Jerome-kai/sickcamera/software/assets/boot-screen.png

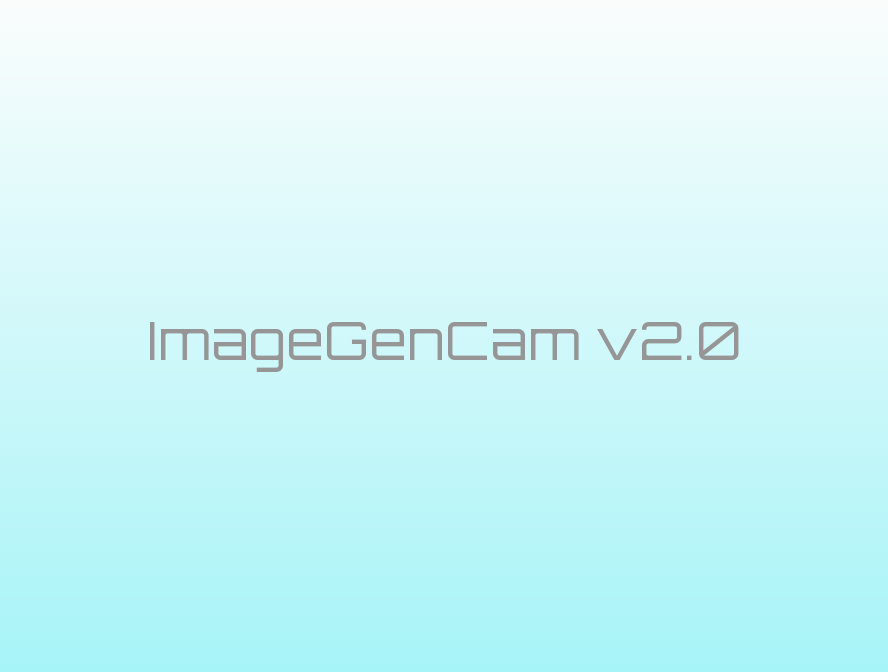
software/assets/boot-screen.png
