Jerome-kai/sickcamera/3d model/step/Folding Case.step

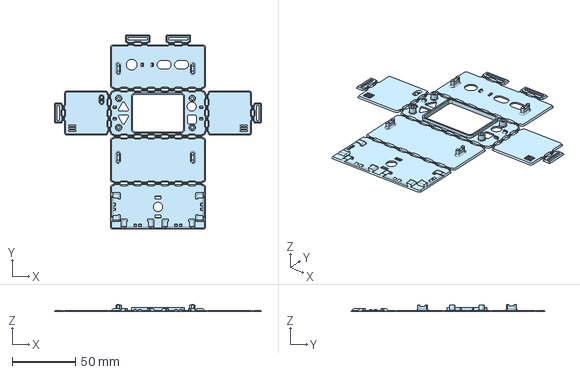
[picture p6: CAD file, 2026-07-07]
3d model/step/Folding Case.step
163.2 x 153.1 x 5.55 mm
