Jerome-kai/sickcamera/3d model/step/Clip On Lens.step

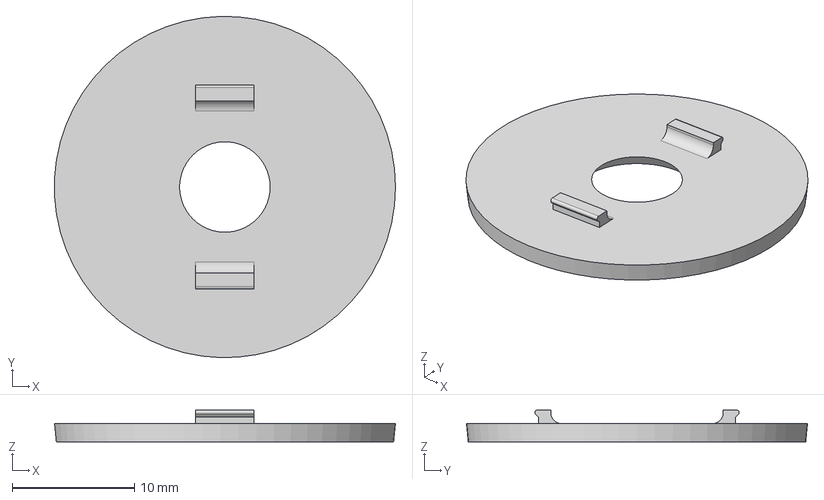
[picture p7: CAD file, 2026-07-07]
3d model/step/Clip On Lens.step
27.9 x 27.9 x 2.61 mm
