Jerome-kai/sickcamera/3d model/step/Buttons - Circle Square.step

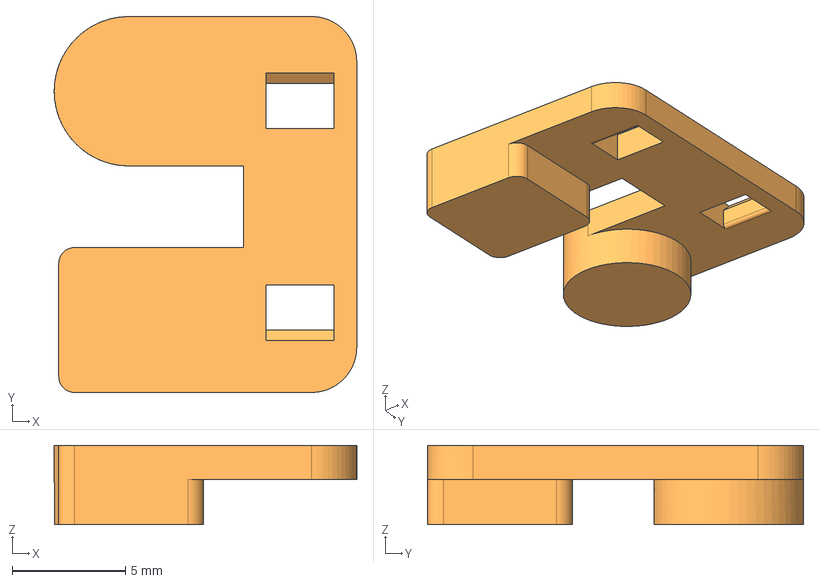
[picture p8: CAD file, 2026-07-07]
3d model/step/Buttons - Circle Square.step
13.4 x 16.6 x 3.50 mm
