Jerome-kai/sickcamera/3d model/step/Buttons - Top.step

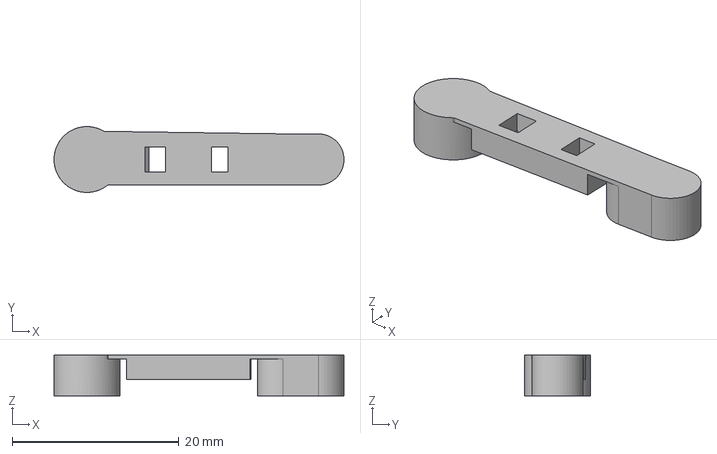
[picture p9: CAD file, 2026-07-07]
3d model/step/Buttons - Top.step
34.8 x 7.90 x 4.90 mm
