Jerome-kai/sickcamera/3d model/step/Buttons - Arrows.step

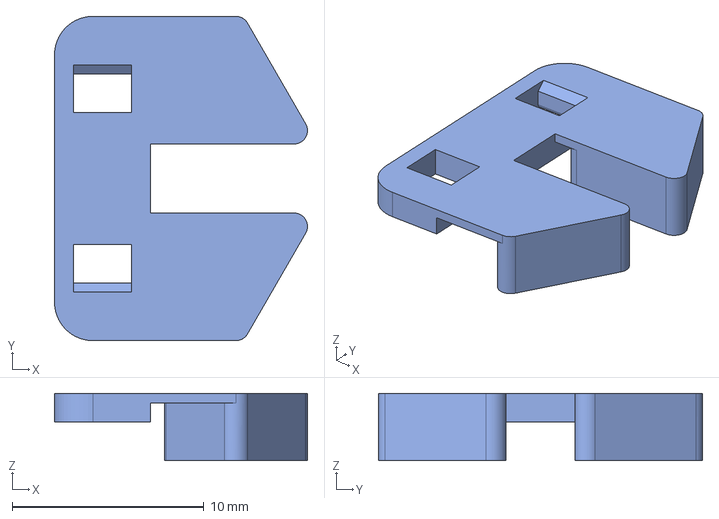
[picture p10: CAD file, 2026-07-07]
3d model/step/Buttons - Arrows.step
13.2 x 16.9 x 3.50 mm
