Jerome-kai/sickcamera/(list of files, cad)

Other CAD files:
3d model/stl/Buttons - Arrows.stl
3d model/stl/Buttons - Circle Square.stl
3d model/stl/Buttons - Top.stl
3d model/stl/Clip On Lens.stl
