Jerome-kai/sickcamera/assets/experiments-motion-sketch.gif

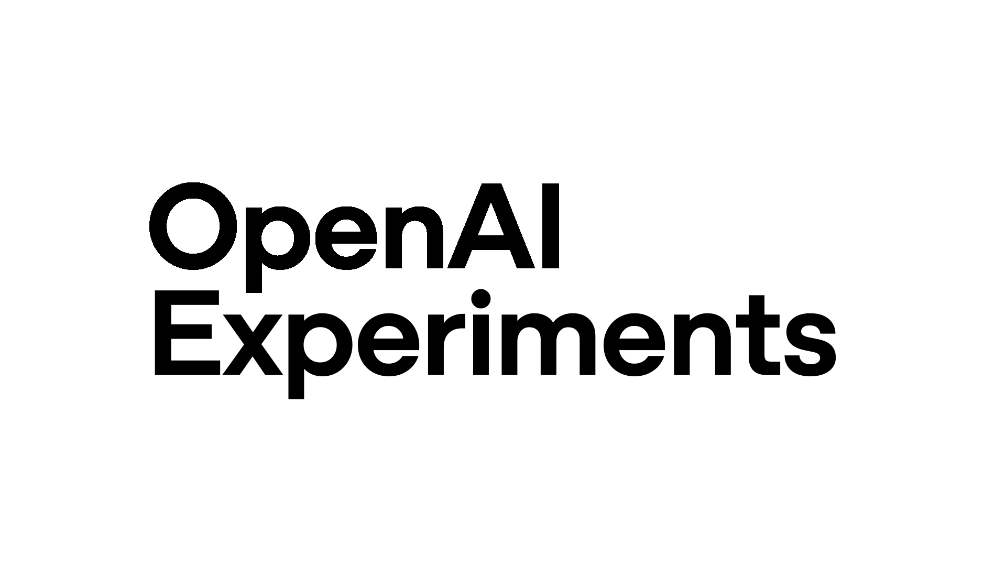
assets/experiments-motion-sketch.gif
