Jerome-kai/sickcamera/software/tests/test_web.py

from __future__ import annotations

import socket
import tempfile
import unittest
import zipfile
from http.server import ThreadingHTTPServer
from io import BytesIO
from pathlib import Path
from threading import Lock, Thread

from imagegencam.controller import ImageGenCamController

from imagegencam.web import (
    MAX_POST_BODY_BYTES,
    build_handler,
    build_generated_images_zip,
    build_generated_image_list,
    build_selected_images_zip,
    delete_generated_image_by_relative_path,
    get_capture_image_by_relative_path,
    get_generated_image_by_relative_path,
    get_latest_generated_path,
    get_or_create_thumbnail,
    json_for_inline_script,
    read_project_asset,
    render_page,
)


class _FakeState:
    def __init__(self, last_generated_path: str | None = None) -> None:
        self.last_generated_path = last_generated_path
        self.ready_images = 0


class _FakeController:
    """Stands in for ImageGenCamController, which cannot be constructed in a
    test because its __init__ opens the camera and the display.

    It binds the REAL delete_generated_image rather than omitting it. Omitting
    it made `hasattr(controller, "delete_generated_image")` false, so every
    delete test silently exercised web.py's fallback branch -- a branch that
    never runs on the device, because the real controller always defines the
    method. Any attribute the real method touches has to exist here."""

    def __init__(self, project_root: Path, last_generated_path: str | None = None) -> None:
        self.project_root = project_root
        self.generated_root = project_root / "data" / "generated"
        self._snapshot = {"last_generated_path": last_generated_path}
        self.gallery_paths: list[Path] = []
        self.album_cached_path: Path | None = None
        self.album_index = 0
        self.state = _FakeState(last_generated_path)
        self.state_lock = Lock()

    delete_generated_image = ImageGenCamController.delete_generated_image
    # staticmethod: re-wrap it, or the class body turns it back into an
    # instance method and `self` is passed as the path.
    _is_generated_image_file = staticmethod(ImageGenCamController._is_generated_image_file)
    _get_generated_metadata_path = ImageGenCamController._get_generated_metadata_path

    def _invalidate_album_cache(self) -> None:
        self.album_cached_path = None

    def get_status_snapshot(self) -> dict[str, str | None]:
        return dict(self._snapshot)

    def get_prompt_entries(self) -> list[dict[str, str]]:
        return [
            {"id": "prompt-1", "title": "First", "body": "First prompt"},
            {"id": "prompt-2", "title": "Second", "body": "Second prompt"},
        ]

    def update_prompt_entries(self, prompts: object) -> list[dict[str, str]]:
        # /save calls this; without it the handler raised and the connection
        # closed with no response at all.
        self.saved_prompts = prompts
        return self.get_prompt_entries()

    def get_device_details(self) -> dict[str, object]:
        return {
            "battery_status": "74% charging",
            "wifi_network": "Studio Wi-Fi",
            "ip_address": "192.168.1.42",
            "mac_address": "00:11:22:33:44:55",
            "hostname": "imagegencam",
            "app_url": "http://imagegencam.local",
            "storage_status": "12.0 GB free of 32.0 GB",
            "cpu_status": "8%",
        }


class LatestGeneratedPathTests(unittest.TestCase):
    def test_returns_none_when_only_gitkeep_exists(self) -> None:
        with tempfile.TemporaryDirectory() as tmp:
            project_root = Path(tmp)
            generated_root = project_root / "data" / "generated"
            generated_root.mkdir(parents=True, exist_ok=True)
            (generated_root / ".gitkeep").write_text("\n", encoding="utf-8")

            controller = _FakeController(project_root)

            self.assertIsNone(get_latest_generated_path(controller))

    def test_falls_back_to_newest_real_image(self) -> None:
        with tempfile.TemporaryDirectory() as tmp:
            project_root = Path(tmp)
            generated_root = project_root / "data" / "generated" / "2026-04-14"
            generated_root.mkdir(parents=True, exist_ok=True)
            older = generated_root / "older.jpg"
            newer = generated_root / "newer.webp"
            older.write_bytes(b"older")
            newer.write_bytes(b"newer")

            controller = _FakeController(project_root, last_generated_path=str(generated_root / "missing.jpg"))

            self.assertEqual(get_latest_generated_path(controller), newer)

    def test_generated_image_list_includes_download_url(self) -> None:
        with tempfile.TemporaryDirectory() as tmp:
            project_root = Path(tmp)
            generated_root = project_root / "data" / "generated" / "2026-05-07"
            generated_root.mkdir(parents=True, exist_ok=True)
            image_path = generated_root / "story.jpg"
            image_path.write_bytes(b"story")

            controller = _FakeController(project_root)

            items = build_generated_image_list(controller)

            self.assertEqual(len(items), 1)
            self.assertEqual(items[0]["image_url"], "/generated/2026-05-07/story.jpg")
            self.assertEqual(items[0]["download_url"], "/download/generated/2026-05-07/story.jpg")
            self.assertEqual(items[0]["relative_path"], "2026-05-07/story.jpg")

    def test_generated_images_zip_includes_all_images(self) -> None:
        with tempfile.TemporaryDirectory() as tmp:
            project_root = Path(tmp)
            generated_root = project_root / "data" / "generated" / "2026-05-07"
            generated_root.mkdir(parents=True, exist_ok=True)
            (generated_root / "first.jpg").write_bytes(b"first")
            (generated_root / "second.webp").write_bytes(b"second")

            controller = _FakeController(project_root)

            archive = zipfile.ZipFile(BytesIO(build_generated_images_zip(controller)))

            self.assertEqual(
                sorted(archive.namelist()),
                ["2026-05-07/first.jpg", "2026-05-07/second.webp"],
            )

    def test_delete_generated_image_removes_file_and_metadata(self) -> None:
        with tempfile.TemporaryDirectory() as tmp:
            project_root = Path(tmp)
            generated_root = project_root / "data" / "generated" / "2026-05-07"
            generated_root.mkdir(parents=True, exist_ok=True)
            image_path = generated_root / "story.jpg"
            metadata_path = generated_root / "story.jpg.json"
            image_path.write_bytes(b"story")
            metadata_path.write_text("{}", encoding="utf-8")

            controller = _FakeController(project_root)

            self.assertTrue(delete_generated_image_by_relative_path(controller, "2026-05-07/story.jpg"))
            self.assertFalse(image_path.exists())
            self.assertFalse(metadata_path.exists())

    def test_delete_generated_image_removes_cached_thumbnail(self) -> None:
        from PIL import Image

        with tempfile.TemporaryDirectory() as tmp:
            project_root = Path(tmp)
            generated_root = project_root / "data" / "generated" / "day"
            generated_root.mkdir(parents=True, exist_ok=True)
            Image.new("RGB", (800, 600), (90, 90, 90)).save(generated_root / "shot.jpg", "JPEG")
            controller = _FakeController(project_root)

            thumb = get_or_create_thumbnail(controller, "day/shot.jpg")
            self.assertTrue(thumb.is_file())

            self.assertTrue(delete_generated_image_by_relative_path(controller, "day/shot.jpg"))
            self.assertFalse(thumb.exists())

    def test_generated_image_lookup_rejects_path_traversal(self) -> None:
        with tempfile.TemporaryDirectory() as tmp:
            project_root = Path(tmp)
            generated_root = project_root / "data" / "generated"
            generated_root.mkdir(parents=True, exist_ok=True)
            outside = project_root / "secret.jpg"
            outside.write_bytes(b"secret")

            controller = _FakeController(project_root)

            self.assertIsNone(get_generated_image_by_relative_path(controller, "../secret.jpg"))

    def test_capture_image_lookup_rejects_path_traversal(self) -> None:
        with tempfile.TemporaryDirectory() as tmp:
            project_root = Path(tmp)
            capture_root = project_root / "data" / "captures"
            capture_root.mkdir(parents=True, exist_ok=True)
            outside = project_root / "secret.jpg"
            outside.write_bytes(b"secret")

            controller = _FakeController(project_root)

            self.assertIsNone(get_capture_image_by_relative_path(controller, "../secret.jpg"))

    def test_prompt_editor_autosaves_without_save_button(self) -> None:
        with tempfile.TemporaryDirectory() as tmp:
            controller = _FakeController(Path(tmp))

            html = render_page(controller).decode("utf-8")

            self.assertIn('data-tab="prompt">Prompts</button>', html)
            self.assertIn("<h3>Prompts</h3>", html)
            self.assertNotIn("Autosaves changes.", html)
            self.assertIn("schedulePromptSave", html)
            self.assertNotIn('id="save-prompts-button"', html)

    def test_gallery_has_all_and_selected_photo_actions(self) -> None:
        with tempfile.TemporaryDirectory() as tmp:
            controller = _FakeController(Path(tmp))

            html = render_page(controller).decode("utf-8")

            self.assertIn("Download All", html)
            self.assertIn('id="download-selected-button"', html)
            self.assertIn('id="delete-selected-button"', html)
            self.assertIn('id="select-toggle-button"', html)
            self.assertIn("/download/selected", html)
            self.assertIn("/api/images/delete", html)
            self.assertIn("relative_paths: paths", html)
            self.assertIn("thumb_url", html)

    def test_selected_zip_contains_only_requested_images(self) -> None:
        from PIL import Image

        with tempfile.TemporaryDirectory() as tmp:
            project_root = Path(tmp)
            generated_root = project_root / "data" / "generated" / "day"
            generated_root.mkdir(parents=True, exist_ok=True)
            for name in ("a.jpg", "b.jpg", "c.jpg"):
                Image.new("RGB", (8, 8), (200, 100, 50)).save(generated_root / name, "JPEG")
            controller = _FakeController(project_root)

            body = build_selected_images_zip(controller, ["day/a.jpg", "day/c.jpg", "../evil.jpg"])

            self.assertIsNotNone(body)
            with zipfile.ZipFile(BytesIO(body)) as archive:
                self.assertEqual(sorted(archive.namelist()), ["day/a.jpg", "day/c.jpg"])
            self.assertIsNone(build_selected_images_zip(controller, ["missing.jpg"]))

    def test_thumbnail_created_smaller_and_cached(self) -> None:
        from PIL import Image

        with tempfile.TemporaryDirectory() as tmp:
            project_root = Path(tmp)
            generated_root = project_root / "data" / "generated" / "day"
            generated_root.mkdir(parents=True, exist_ok=True)
            Image.new("RGB", (1024, 768), (10, 120, 200)).save(generated_root / "big.jpg", "JPEG")
            controller = _FakeController(project_root)

            thumb = get_or_create_thumbnail(controller, "day/big.jpg")

            self.assertIsNotNone(thumb)
            with Image.open(thumb) as reduced:
                self.assertLessEqual(max(reduced.size), 360)
            first_mtime = thumb.stat().st_mtime_ns
            again = get_or_create_thumbnail(controller, "day/big.jpg")
            self.assertEqual(again, thumb)
            self.assertEqual(again.stat().st_mtime_ns, first_mtime)
            self.assertIsNone(get_or_create_thumbnail(controller, "../escape.jpg"))

    def test_batch_delete_endpoint_removes_all_requested_images(self) -> None:
        import json
        import urllib.request

        from imagegencam.web import WebServerThread

        with tempfile.TemporaryDirectory() as tmp:
            project_root = Path(tmp)
            generated_root = project_root / "data" / "generated" / "day"
            generated_root.mkdir(parents=True, exist_ok=True)
            for name in ("a.jpg", "b.jpg", "c.jpg"):
                (generated_root / name).write_bytes(b"img")
            controller = _FakeController(project_root)

            server = WebServerThread(controller, "127.0.0.1", 0)
            server.start()
            try:
                port = server.server.server_address[1]
                request = urllib.request.Request(
                    f"http://127.0.0.1:{port}/api/images/delete",
                    data=json.dumps(
                        {"relative_paths": ["day/a.jpg", "day/c.jpg", "day/missing.jpg"]}
                    ).encode(),
                    headers={"Content-Type": "application/json"},
                    method="POST",
                )
                with urllib.request.urlopen(request, timeout=5) as response:
                    payload = json.loads(response.read())
            finally:
                server.stop()

            self.assertEqual(payload["deleted"], 2)
            self.assertEqual(payload["failed"], ["day/missing.jpg"])
            self.assertFalse(payload["ok"])
            self.assertEqual([item["filename"] for item in payload["images"]], ["b.jpg"])
            self.assertFalse((generated_root / "a.jpg").exists())
            self.assertTrue((generated_root / "b.jpg").exists())

    def test_remote_tab_renders_virtual_buttons(self) -> None:
        with tempfile.TemporaryDirectory() as tmp:
            controller = _FakeController(Path(tmp))

            html = render_page(controller).decode("utf-8")

            self.assertIn('data-tab="remote"', html)
            self.assertIn('id="panel-remote"', html)
            for name in ("ui_up", "ui_down", "ui_album", "ui_prompt", "shutter", "magic_shutter"):
                self.assertIn(f'data-button="{name}"', html)
            self.assertIn("/api/button", html)

    def test_button_endpoint_calls_controller_and_rejects_unknown(self) -> None:
        import json
        import urllib.error
        import urllib.request

        from imagegencam.web import WebServerThread

        class _RemoteController(_FakeController):
            def __init__(self, project_root: Path) -> None:
                super().__init__(project_root)
                self.pressed: list[str] = []

            def press_virtual_button(self, name: str) -> bool:
                if name not in {"shutter", "ui_up"}:
                    return False
                self.pressed.append(name)
                return True

        def post(port: int, body: dict) -> int:
            request = urllib.request.Request(
                f"http://127.0.0.1:{port}/api/button",
                data=json.dumps(body).encode(),
                headers={"Content-Type": "application/json"},
                method="POST",
            )
            try:
                with urllib.request.urlopen(request, timeout=5) as response:
                    return response.status
            except urllib.error.HTTPError as exc:
                return exc.code

        with tempfile.TemporaryDirectory() as tmp:
            controller = _RemoteController(Path(tmp))
            server = WebServerThread(controller, "127.0.0.1", 0)
            server.start()
            try:
                port = server.server.server_address[1]
                self.assertEqual(post(port, {"button": "shutter"}), 200)
                self.assertEqual(post(port, {"button": "nonsense"}), 400)
                self.assertEqual(post(port, {}), 400)
            finally:
                server.stop()

        self.assertEqual(controller.pressed, ["shutter"])

    def test_wifi_tab_renders_the_setup_picker(self) -> None:
        with tempfile.TemporaryDirectory() as tmp:
            controller = _FakeController(Path(tmp))

            html = render_page(controller).decode("utf-8")

            self.assertIn('data-tab="wifi"', html)
            self.assertIn('id="panel-wifi"', html)
            self.assertIn("/api/wifi/networks", html)
            self.assertIn("/api/wifi/connect", html)
            self.assertIn("/api/wifi/status", html)

    def test_wifi_endpoints_expose_status_networks_and_connect(self) -> None:
        import json
        import urllib.error
        import urllib.request

        from imagegencam.web import WebServerThread

        class _WifiController(_FakeController):
            def __init__(self, project_root: Path) -> None:
                super().__init__(project_root)
                self.attempts: list[tuple[str, str]] = []

            def setup_portal_status(self) -> dict:
                return {"online": False, "portal_active": True, "portal_ssid": "ImageGenCam-Setup"}

            def list_wifi_networks_for_web(self) -> list[dict]:
                return [{"ssid": "Home WiFi", "saved": False, "active": False, "secure": True, "signal": 71}]

            def begin_wifi_connect_from_web(self, ssid: str, password: str = "") -> dict:
                self.attempts.append((ssid, password))
                return {"ok": True, "applying": True, "ssid": ssid}

        def get(port: int, path: str) -> tuple[int, dict]:
            with urllib.request.urlopen(f"http://127.0.0.1:{port}{path}", timeout=5) as response:
                return response.status, json.loads(response.read())

        def post(port: int, body: dict) -> int:
            request = urllib.request.Request(
                f"http://127.0.0.1:{port}/api/wifi/connect",
                data=json.dumps(body).encode(),
                headers={"Content-Type": "application/json"},
                method="POST",
            )
            try:
                with urllib.request.urlopen(request, timeout=5) as response:
                    return response.status
            except urllib.error.HTTPError as exc:
                return exc.code

        with tempfile.TemporaryDirectory() as tmp:
            controller = _WifiController(Path(tmp))
            server = WebServerThread(controller, "127.0.0.1", 0)
            server.start()
            try:
                port = server.server.server_address[1]

                status_code, status = get(port, "/api/wifi/status")
                self.assertEqual(status_code, 200)
                self.assertTrue(status["portal_active"])

                networks_code, networks = get(port, "/api/wifi/networks")
                self.assertEqual(networks_code, 200)
                self.assertEqual([item["ssid"] for item in networks["networks"]], ["Home WiFi"])

                self.assertEqual(post(port, {"ssid": "Home WiFi", "password": "hunter22"}), 200)
                self.assertEqual(post(port, {"password": "hunter22"}), 400)
            finally:
                server.stop()

        self.assertEqual(controller.attempts, [("Home WiFi", "hunter22")])

    def test_about_uses_device_details_not_live_preview(self) -> None:
        with tempfile.TemporaryDirectory() as tmp:
            controller = _FakeController(Path(tmp))

            html = render_page(controller).decode("utf-8")

            self.assertIn("device-details", html)
            self.assertIn("battery_status", html)
            self.assertIn("Studio Wi-Fi", html)
            self.assertNotIn("Live device screen preview", html)
            self.assertNotIn("deviceScreenImage", html)

    def test_add_prompt_inserts_at_top(self) -> None:
        with tempfile.TemporaryDirectory() as tmp:
            controller = _FakeController(Path(tmp))

            html = render_page(controller).decode("utf-8")

            self.assertIn("promptEntries.unshift", html)
            self.assertNotIn("promptEntries.push", html)

    def test_prompt_payload_cannot_break_out_of_script_tag(self) -> None:
        payload = [{"id": "prompt-1", "title": "x", "body": '</script><script>alert("x")</script>'}]

        encoded = json_for_inline_script(payload)

        self.assertNotIn("</script>", encoded.lower())
        self.assertIn("\\u003c/script", encoded)

    def test_render_page_escapes_prompt_payload_for_inline_script(self) -> None:
        class EvilPromptController(_FakeController):
            def get_prompt_entries(self) -> list[dict[str, str]]:
                return [
                    {
                        "id": "prompt-1",
                        "title": "x",
                        "body": '</script><script>window.evil = true</script>',
                    }
                ]

        with tempfile.TemporaryDirectory() as tmp:
            controller = EvilPromptController(Path(tmp))

            html = render_page(controller).decode("utf-8")

            self.assertEqual(html.lower().count("</script>"), 2)
            self.assertNotIn("</script><script>window.evil = true", html)
            self.assertIn("\\u003c/script\\u003e", html)


class ProjectAssetTests(unittest.TestCase):
    def _project(self, tmp: str) -> Path:
        root = Path(tmp)
        (root / "assets" / "fonts").mkdir(parents=True)
        (root / "assets" / "fonts" / "Orbitron-Regular.ttf").write_bytes(b"font-bytes")
        (root / ".env").write_text("OPENAI_API_KEY=sk-secret\n", encoding="utf-8")
        (root / "data").mkdir()
        (root / "data" / "prompts.json").write_text("[]\n", encoding="utf-8")
        return root

    def test_serves_a_real_asset(self) -> None:
        with tempfile.TemporaryDirectory() as tmp:
            root = self._project(tmp)

            asset = read_project_asset(root, "/assets/fonts/Orbitron-Regular.ttf")

            self.assertIsNotNone(asset)
            self.assertEqual(asset[0], b"font-bytes")

    def test_refuses_to_climb_out_of_the_assets_directory(self) -> None:
        # http.server hands us the raw request path, so `..` arrives intact.
        # Before this was anchored, the .env file -- and the API key in it --
        # was readable by anyone who could reach the web UI.
        with tempfile.TemporaryDirectory() as tmp:
            root = self._project(tmp)

            for request_path in (
                "/assets/../.env",
                "/assets/../data/prompts.json",
                "/assets/fonts/../../.env",
                "/assets/%2e%2e/.env",
                "/assets/..%2f.env",
            ):
                with self.subTest(request_path=request_path):
                    self.assertIsNone(read_project_asset(root, request_path))

    def test_refuses_paths_outside_the_assets_prefix(self) -> None:
        with tempfile.TemporaryDirectory() as tmp:
            root = self._project(tmp)

            self.assertIsNone(read_project_asset(root, "/.env"))
            self.assertIsNone(read_project_asset(root, "/data/prompts.json"))

    def test_refuses_a_symlink_that_escapes_the_assets_directory(self) -> None:
        with tempfile.TemporaryDirectory() as tmp:
            root = self._project(tmp)
            (root / "assets" / "leak").symlink_to(root / ".env")

            self.assertIsNone(read_project_asset(root, "/assets/leak"))


class RequestBodyLimitTests(unittest.TestCase):
    """Driven over a real socket: the defect was in how the header is parsed
    before any body is read, which a fake request object would not reproduce."""

    def setUp(self) -> None:
        self.tmp = tempfile.TemporaryDirectory()
        root = Path(self.tmp.name)
        (root / "data" / "generated").mkdir(parents=True)
        self.server = ThreadingHTTPServer(
            ("127.0.0.1", 0), build_handler(_FakeController(root))
        )
        Thread(target=self.server.serve_forever, daemon=True).start()
        self.addCleanup(self.tmp.cleanup)
        self.addCleanup(self.server.server_close)
        self.addCleanup(self.server.shutdown)

    def _post(self, content_length: str, body: bytes = b"") -> str:
        """Send one request and return its status line.

        No body is streamed: the header alone has to settle it. If the server
        instead starts reading, it blocks until EOF and recv times out -- which
        is precisely the bug, so a timeout here is a failure, not flakiness.
        """
        host, port = self.server.server_address
        sock = socket.create_connection((host, port), timeout=5)
        try:
            sock.sendall(
                b"POST /save HTTP/1.1\r\nHost: x\r\n"
                b"Content-Type: application/json\r\n"
                b"Content-Length: " + content_length.encode() + b"\r\n\r\n" + body
            )
            sock.settimeout(4)
            try:
                received = sock.recv(200)
            except socket.timeout:
                return "<no response: server is reading the body>"
            return received.decode("utf-8", "replace").splitlines()[0] if received else "<closed>"
        finally:
            sock.close()

    def test_a_negative_content_length_is_rejected(self) -> None:
        # int("-1") parses fine and -1 > MAX_POST_BODY_BYTES is False, so this
        # used to reach rfile.read(-1) -- read-until-EOF, uncapped, on a 512MB
        # board. Answering at all (rather than reading) is the fix.
        self.assertIn("400", self._post("-1"))

    def test_an_oversized_content_length_is_rejected(self) -> None:
        self.assertIn("413", self._post(str(MAX_POST_BODY_BYTES + 1)))

    def test_a_normal_request_still_works(self) -> None:
        body = b'{"prompts":[]}'
        self.assertIn("200", self._post(str(len(body)), body))


if __name__ == "__main__":
    unittest.main()
