Jerome-kai/sickcamera/(commit log)

2026-07-07 Import upstream openai/imagegencam
    Pristine copy of https://github.com/openai/imagegencam (Apache 2.0).
    Claude-Session: https://claude.ai/code/session_018uvgFeGXxCK1JMJAhJVQpJ
    [Buttons - Arrows.step, Buttons - Arrows.stl, Buttons - Circle Square.step, Buttons - Circle Square.stl, Buttons - Top.step, Buttons - Top.stl, Clip On Lens.step, Clip On Lens.stl]
2026-07-07 Port to Orange Pi Zero 2: ST7796 display, USB camera, GPIO buttons, gateway support
    Hardware layer:
    - New st7796.py: self-contained 480x320 ST7796 SPI driver (spidev + gpiod)
    - New opi_hw.py: DisplayHATMini-compatible shim (pillarbox 320x240 UI onto
    480x320 panel, 5 GPIO buttons with pull-ups) and Picamera2-compatible
    UsbCamera (V4L2/OpenCV, MJPG 640x480, fps throttle)
    - controller.py: IMAGEGENCAM_HW import selector (opi|pi), GPIO shutter button
    (short press = shutter, long press = magic_shutter), rotation-aware preview
    crop box, PISUGAR_ENABLED gate
    API routing:
    - openai_client.py: OPENAI_BASE_URL support for OpenAI-compatible gateways
    (e.g. Vercel AI Gateway); handle provider-pr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
    [controller.py, display_test.py, openai_client.py, opi_hw.py, show_boot_splash.py, st7796.py, test_openai_client.py, test_opi_hw.py]
2026-07-07 Support legacy 4.9 kernel (stock Orange Pi Focal image)
    The official Orange Pi Zero 2 Ubuntu 20.04 image ships Linux 4.9, where the
    gpiod v2 character-device API (kernel 5.10+) and chardev pull-up bias
    (kernel 5.5+) are unavailable. Add a sysfs GPIO fallback:
    - New sunxi_gpio.py: backend abstraction (GPIO_BACKEND=auto|gpiod|sysfs).
    sysfs backend uses persistent-fd reads for fast button polling; internal
    pull-ups are written directly to the H616 pin-controller registers via
    /dev/mem (root), with external-resistor fallback documented.
    - st7796.py / opi_hw.py: use the backend instead of gpiod directly.
    - Setup scripts pick a Python 3.10+ interpreter (deadsnakes on Focal) and
    install_se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
2026-07-07 Default SPI device to spidev1.1 for the legacy 4.9 image
    The legacy Orange Pi Focal device tree registers the header SPI1 bus at
    chip-select 1, so the display sits on /dev/spidev1.1 (modern images use
    spidev1.0). Default DISPLAY_SPI_DEV to 1 and document the knob.
    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
2026-07-08 Add gateway_test.py: pre-hardware end-to-end API check
    Exercises the two endpoints the camera uses (/v1/images/edits and
    /v1/responses) against the configured OPENAI_BASE_URL, using a locally
    generated test photo, so the Vercel gateway path can be validated before
    the display and camera arrive.
    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
2026-07-08 Add chat-completions image-edit path for gateways without /v1/images/edits
    The Vercel AI Gateway (and most OpenAI-compatible gateways) 404 on
    /v1/images/edits; their supported editing path is /v1/chat/completions
    with a multimodal image model, source photo attached as a base64 data
    URL and the edited image returned base64-encoded on the message.
    Adds IMAGE_GEN_API=edits|chat to OpenAIImageEditor (env-driven, default
    edits), extracts returned images from either message.images or content
    parts, re-encodes to the configured output format, and updates the
    gateway test, env template, and docs with the Vercel recipe
    (IMAGE_GEN_API=chat + IMAGE_GEN_MODEL=google/gemini-2.5-flash-image).
    Co-Authore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
2026-07-08 Add enclosure & wiring reference site (docs/index.html)
    Self-contained single-page site for designing the camera's enclosure:
    parts list with dimensions, 26-pin header pinout diagram, display/button/
    power wiring schematics, panel cutout specs, and internal layout guidance.
    Ready to serve via GitHub Pages from the docs/ folder.
    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
2026-07-10 Add hot shoe flash trigger via MOC3021 on PC11
    New HotShoe class in opi_hw drives the opto-triac LED (330R from PC11,
    header pin 12) with a configurable pulse; the controller fires it on every
    capture and waits for a frame exposed after the trigger so the flash lights
    the photo. Off by default (HOTSHOE_ENABLED=0). Documented in HARDWARE.md,
    .env.example, and the enclosure site.
    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
2026-07-10 Support 2.8" ILI9341 240x320 panels (DISPLAY_CONTROLLER=ili9341)
    The delivered display is a 2.8" 240x320 capacitive-touch module, not the
    planned 3.2" ST7796. Same header wiring; the driver now selects the init
    sequence and panel size by DISPLAY_CONTROLLER. Landscape 320x240 matches
    the UI exactly, so the ILI9341 path blits with no scaling. display_test
    and docs updated; touch and SD pins stay unconnected.
    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
2026-07-10 Display is a 3.5" ST7796U MSP3526: correct docs, keep st7796 default
    The delivered module's spec sheet identifies it as the lcdwiki MSP3526 —
    3.5" 320x480 ST7796U with FT6336U capacitive touch — so the original
    st7796 driver default stands (the ili9341 option remains for 2.8" panels).
    Key wiring correction from the spec: the module wants 5V on VCC (0.5W,
    onboard regulator), so VCC moves to header pin 2. Docs, .env.example, and
    the enclosure site updated with real MSP3526 dimensions.
    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
2026-07-13 Document header powering, 13-pin USB camera port, and 5V battery pack
    Per the Zero 2 user manual (sections 2.8, 2.9, 3.17): power the board through
    26-pin 5V pins 2+4 from a single-18650 5V pack via a small distribution
    perfboard (master switch + fan-out to Pi, display, camera), and solder the
    UVC camera to the 13-pin header's USB2 port (pins 1-4). Frees the chassis
    from USB-A and USB-C cutouts entirely.
    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
2026-07-13 UI buttons switch to 6x6 tactile switches on a perfboard strip
    Shutter stays MX; the four UI buttons become 6x6mm through-hole tacts
    mounted on a perfboard behind the front wall, stems through 4mm holes.
    Documents the diagonal-pin rule for 4-leg tacts and stem-height math.
    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
2026-07-15 Overhaul web gallery for downloading; mirror UI tabs for right-side buttons
    Web app: gallery is now the landing tab; the grid loads cached 360px
    server-side thumbnails instead of full images (roughly 20x less data);
    a Select mode allows multi-select with per-set ZIP download
    (POST /download/selected) and batch delete; the viewer shows
    filename/date/size. New tests for the zip and thumbnail helpers.
    Camera UI: UI_CONTROLS_SIDE=right mirrors all on-screen hint tabs (and
    the unseen-photos sparkle) to the right edge, matching this chassis's
    diamond button cluster right of the screen. Enclosure page FIG 5 redrawn
    to the diamond layout.
    Clau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
2026-07-15 Batch delete, thumbnail cache cleanup, and hardware bring-up test scripts
    - Deleting a photo (camera or web) now removes its cached gallery thumbnail
    so the SD card doesn't accumulate orphaned thumbs; cache dir gitignored.
    - POST /api/images/delete accepts relative_paths[] so deleting N selected
    photos is one request instead of N sequential ones; UI reports the count.
    - Thumbnails respect EXIF orientation (ImageOps.exif_transpose).
    - New scripts/button_test.py (named DOWN/up per switch) and
    scripts/hotshoe_test.py (pulse the MOC3021 trigger) for assembly bring-up;
    HARDWARE.md bring-up sequence updated to use them.
    Claude-Session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
    [button_test.py, controller.py, hotshoe_test.py, test_web.py, web.py]
2026-07-15 Address review findings on batch delete and thumbnail cleanup
    - /api/images/delete batch form now returns 200 with a failed[] list instead
    of 404-on-all-failed or silently dropping partial failures; the UI keeps
    genuinely failed photos selected and reports the count, while paths that
    were already gone (stale grid) just clear.
    - Thumbnail cache path lives in one helper (web.thumbnail_path /
    delete_cached_thumbnail) used by creation, the web fallback delete, and
    controller.delete_generated_image.
    - button_test.py reads DisplayHATMini.BUTTON_* constants instead of
    re-declaring env names and default pins.
    Claude-Session: https:/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
    [button_test.py, controller.py, test_web.py, web.py]
2026-07-19 Support Chinese OpenAI-compatible providers (SiliconFlow-style APIs)
    - IMAGE_GEN_API=generations: image editing via /v1/images/generations with
    an image data-URL field (SiliconFlow Qwen-Image-Edit, Volcano Ark
    SeedEdit); handles https-URL and b64_json responses, posts via urllib
    since the OpenAI SDK images API has no such field.
    - MAGIC_MODE_API=chat: magic-mode prompt planning over plain
    /v1/chat/completions for providers without a /v1/responses endpoint,
    with lenient JSON extraction (code fences, surrounding prose).
    - gateway_test.py prints both modes and the China recipe on failure;
    .env.example documents the SiliconFlow setup.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
    [gateway_test.py, openai_client.py, test_openai_client.py]
2026-07-20 Enclosure site: add FIG 4c camera USB wiring schematic (rev G)
    Draws the 13-pin header pins 1-4 to camera-module hookup with wire colors,
    the twisted D-/D+ pair, shield-braid grounding, pin-1 orientation relative
    to the Ethernet jack, and the spare second USB port.
    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
2026-07-24 Fix GPIO backend selection on the legacy 4.9 kernel
    Two bugs surfaced during on-device bring-up on the Orange Pi Focal image:
    - request_outputs/request_inputs only caught ImportError/OSError/
    NotImplementedError, but libgpiod v2 raises ValueError('line offset of out
    range') when the chip's line offsets don't match the sunxi numbering. In
    auto mode that escaped instead of falling back to sysfs, crashing every
    hardware script. Catch ValueError too.
    - display_test.py / button_test.py / hotshoe_test.py never loaded .env, so
    GPIO_BACKEND, DISPLAY_INVERT, DISPLAY_SPI_DEV and friends were ignored when
    the scripts ran standalone. Load .env like gateway_test.py does.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
    [button_test.py, display_test.py, hotshoe_test.py, sunxi_gpio.py, test_sunxi_gpio.py]
2026-07-24 Blit full frames with one writebytes2 call
    show() was slicing the RAMWR payload into 4 KB pieces in Python — one
    ioctl round-trip per slice, ~75 per frame — which capped the panel at
    ~5 fps while the camera delivered 13+. writebytes2 already chunks to the
    kernel bufsiz in C, so hand it the whole frame. Regression test asserts
    the single-call behavior; HARDWARE.md documents the companion
    spidev.bufsiz=65536 boot arg for 8x fewer ioctls.
    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
2026-07-24 Add button_wiggle_test.py for hunting loose button wiring
    Live dashboard of all five lines with per-button transition counters:
    wiggling a wire that makes the counter climb without a press pinpoints
    the flaky joint. Prints an open-circuit / chatty-line summary on exit.
    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
    [button_wiggle_test.py]
2026-07-24 Web remote: five virtual buttons drive the camera from a phone
    New Remote tab in the web UI laid out like the physical diamond cluster
    (UP / ALBM / PRMPT / DOWN) plus SHUTTER and MAGIC, posting to a new
    /api/button endpoint. controller.press_virtual_button() feeds the same
    debounced event queue the GPIO switches use, so behavior is identical.
    Lets the camera be tested end to end before the buttons are wired.
    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
2026-08-07 Join Wi-Fi from a phone with no terminal and no buttons
    A camera given away boots where none of its saved networks exist, and its web
    UI is only reachable once it is already online. Close that loop with a setup
    hotspot: when no network turns up within the grace period, the camera publishes
    its own WPA2 AP and prints the join details on the display, and the web UI gains
    a Wi-Fi tab that scans, takes a password, and joins.
    The radio cannot do both at once, so joining always tears the hotspot down
    first. That kills the requesting phone's connection, so the switch runs in a
    background thread and the response is sent while the link still works, carrying
    the address to reconnect to. A failed atte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
    [controller.py, test_web.py, test_wifi_setup.py, web.py, wifi_setup.py]
2026-08-08 Retry known networks instead of camping on the setup hotspot
    A hotspot cannot scan or auto-join, so a camera that came up before the router
    did would stay in setup mode indefinitely -- the owner's network reappearing a
    minute later went unnoticed. That is a support call for someone holding a gift
    with no terminal.
    The portal now drops the hotspot on an interval, rescans, and gives
    NetworkManager a window to rejoin, republishing only if nothing answers. The
    scan doubles as a refresh of the list the picker offers, which was previously
    frozen at whatever was visible before the hotspot came up.
    Retries are skipped while the setup page is being used, so the hotspot is never
    pulled out from unde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
    [controller.py, test_wifi_setup.py, web.py]
2026-08-13 Wait for the USB camera instead of dying before it enumerates
    The service has no ordering dependency on the camera, so at boot it starts
    while the USB device is still enumerating. UsbCamera.start() failed on the
    first unopened handle, the process exited, and with a three second restart
    delay against a thirty second burst window systemd exhausted the budget in
    well under a minute and gave up on the unit for good. Starting it from a shell
    later always worked, because by then the device had been present for minutes --
    which is exactly what the symptom looked like.
    start() now retries for CAMERA_OPEN_TIMEOUT_SECONDS, covering both a missing
    device node and one that opens but has no frames ready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
    [opi_hw.py, test_opi_hw.py]
2026-08-13 Stop /assets/ from reading the rest of the project
    The static-asset route resolved the request path against the whole
    project root, and http.server does not collapse `..` for us, so
    `GET /assets/../.env` returned the file holding OPENAI_API_KEY to any
    unauthenticated caller -- including anyone in radio range while the
    setup hotspot is up.
    Anchor the check to project_root/assets, resolve both sides before
    comparing, and unquote first so percent-encoded traversal is caught by
    the same guard. A symlink pointing out of assets/ is rejected too.
    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
    [test_web.py, web.py]
2026-08-13 Survive a corrupt store, a stuck job, and a slow udev
    Three startup and queue robustness fixes found in the audit.
    Config stores now write atomically and read tolerantly. prompts.json
    was rewritten in place on a keystroke debounce, so a power cut -- and
    this camera has no shutdown button -- could truncate it. The three
    stores are then loaded unguarded from the controller constructor, so
    the damaged file raised on every start and systemd's restart budget
    disabled the unit outright: the same failure mode as the camera race.
    Writes go through a temp file with fsync on both the file and its
    directory; reads fall back to defaults and set the damaged file aside
    as <name>.corrupt rather than raisi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
    [config.py, controller.py, sunxi_gpio.py, test_config.py, test_generation_queue.py, test_sunxi_gpio.py]
2026-08-29 Add the V2 product roadmap
    Power/boot (the power-line switch is the root cause of the 5-minute
    boots), a first carrier PCB, UX (ship prompt-images, on-device Wi-Fi
    manager, first-run tutorial), and per-device hotspot passwords --
    sequenced so software milestones lead and hardware follows.
    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
2026-08-29 Per-device hotspot password, Wi-Fi forget, tutorial, screen sleep
    Four v2 roadmap items that need no new hardware.
    The setup hotspot password is now unique per camera: generated from an
    unambiguous alphabet on first use, kept in data/ap_password (0600,
    gitignored), and shown on the display next to the SSID -- so nothing
    printed in this repository gets a stranger onto the camera while its
    hotspot is up. WIFI_SETUP_AP_PASSWORD still pins a fixed one.
    The on-device Wi-Fi list gains a Forget option on saved networks
    (including the active one -- that is how you leave a network you no
    longer trust). wifi_manager deletes a profile only from this explicit
    action, and the sudoers rules grow the mat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
    [config.py, controller.py, test_ux.py, test_wifi_manager.py, test_wifi_setup.py, wifi_manager.py, wifi_setup.py]
2026-08-31 Fix six audit findings: root escalation, brick paths, silent stalls
    Root escalation at next boot. imagegencam-boot-splash.service ran as
    root with ExecStart pointing at the project's own venv interpreter and
    script -- both owned by the unprivileged service user, and reachable by
    anything that can write as that user, including via the unauthenticated
    web UI. Replacing either file bought root on the next reboot. The splash
    now runs as the service user with the gpio/spi/video groups. The one
    genuinely privileged step, the H616 pull-up write through /dev/mem, moves
    to imagegencam-pullups.service running a stdlib-only script installed
    root-owned in /usr/local/lib/imagegencam, so root never execut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
    [controller.py, openai_client.py, test_generation_queue.py, test_ux.py, test_web.py]
2026-08-31 Reject a negative Content-Length before reading the body
    int("-1") parses cleanly and -1 > MAX_POST_BODY_BYTES is False, so a
    negative Content-Length slipped past the 128KB ceiling and reached
    rfile.read(-1) -- which on a BufferedReader means read until EOF. With no
    socket timeout set, one unauthenticated LAN POST could stream unbounded
    data into memory on a 512MB board until the OOM killer took the camera,
    and repeating it would exhaust the unit's restart budget.
    Verified against a live server: 13MB streamed with Content-Length: -1 now
    draws an immediate 400 instead of being swallowed.
    The regression test drives a real socket, because the defect is in header
    parsing that happens before an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
    [test_web.py, web.py]
2026-09-02 Raise the preview frame rate and make the redraw budgets tunable
    The preview was pinned at 8fps by a hardcoded constant and the camera at
    10, while the CPU sat around 20%. Defaults are now 15fps for both, with
    menus and the album at 10 -- they are static between key presses, so
    spending SPI bandwidth on them buys nothing.
    The ceiling here is the SPI link, not the processor: a full 480x320
    RGB565 frame is 307200 bytes, so at DISPLAY_SPI_HZ=40MHz one frame costs
    ~61ms and ~16fps is the most that is reachable however idle the CPU is.
    Going beyond that means raising the SPI clock first, so .env.example and
    HARDWARE.md carry the frame-time table (50MHz -> ~20fps, 62.5MHz ->
    ~25fps) and the warni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
2026-09-02 Cut SPI transfer overhead and add a display benchmark
    The frame rate ceiling was blamed on the SPI clock, but the default
    spidev bufsiz of 4096 bytes splits every 480x320 RGB565 frame into 75
    separate transfers, with the clock idling between each -- overhead
    stacked on top of the ~61ms the bits themselves cost at 40MHz. A 64KB
    buffer cuts that to 5 transfers. install_service.sh now writes
    /etc/modprobe.d/imagegencam-spidev.conf, and says what to do instead
    when spidev is built into the kernel rather than a module.
    scripts/display_benchmark.py measures real frames at several clock
    rates and prints theoretical bit time, measured frame time and the gap
    between them, so the next tuning step is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
2026-09-05 Add an optional model wheel: a rotary encoder that picks the AI model
    Turn it like a lens dial and the model list appears; it applies live and
    fades back to the viewfinder on its own. Off unless MODEL_WHEEL_ENABLED=1,
    so a camera with no encoder wired behaves exactly as before.
    Decoding is a quadrature transition table rather than the usual "watch A,
    sample B" shortcut, which counts every contact bounce as a step -- a
    wheel that jumps two models per click is worse than no wheel. Verified
    against simulated waveforms: full turns both ways, a half turn that stays
    pending until completed, bounce on one pin, and jitter within a detent.
    Polling rides the existing ~200Hz input loop, which is far f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
    [app.py, config.py, controller.py, opi_hw.py, test_model_wheel.py, web.py]
